omikader/ENEE408I/(commit log)

2018-02-20 Arduino code for ping sensors and motors
2018-02-27 Add camera facial recognition code
2018-03-27 add sample image for face_recognition lib
2018-05-01 changes to arduino
2018-05-07 Comment out serial prints
